Horymir23/iaapa2026-stand/assets/grafika/2 TV 55.jpg

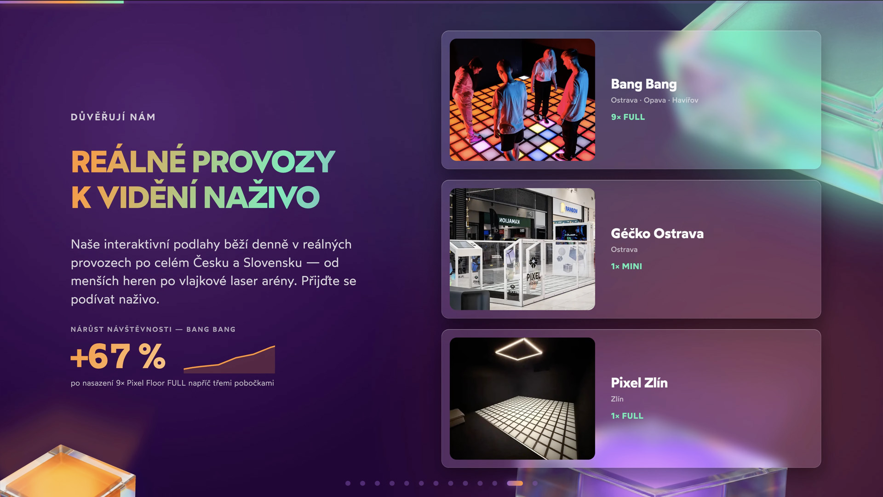
assets/grafika/2 TV 55.jpg
