Horymir23/iaapa2026-stand/assets/grafika/Poutač360v2.jpg

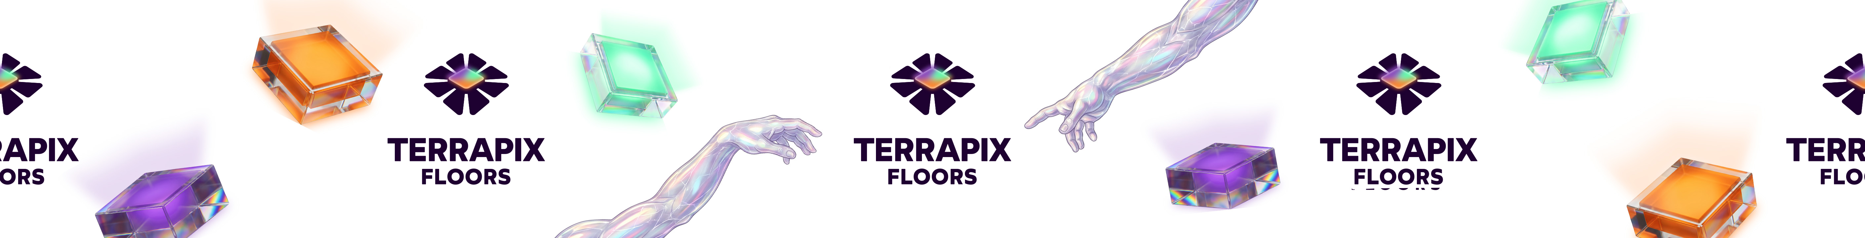
assets/grafika/Poutač360v2.jpg
