Horymir23/iaapa2026-stand/data/Shell Scheme.pdf

## IAAPA Expo Europe 2026

## BLANK SHELL BOOTH

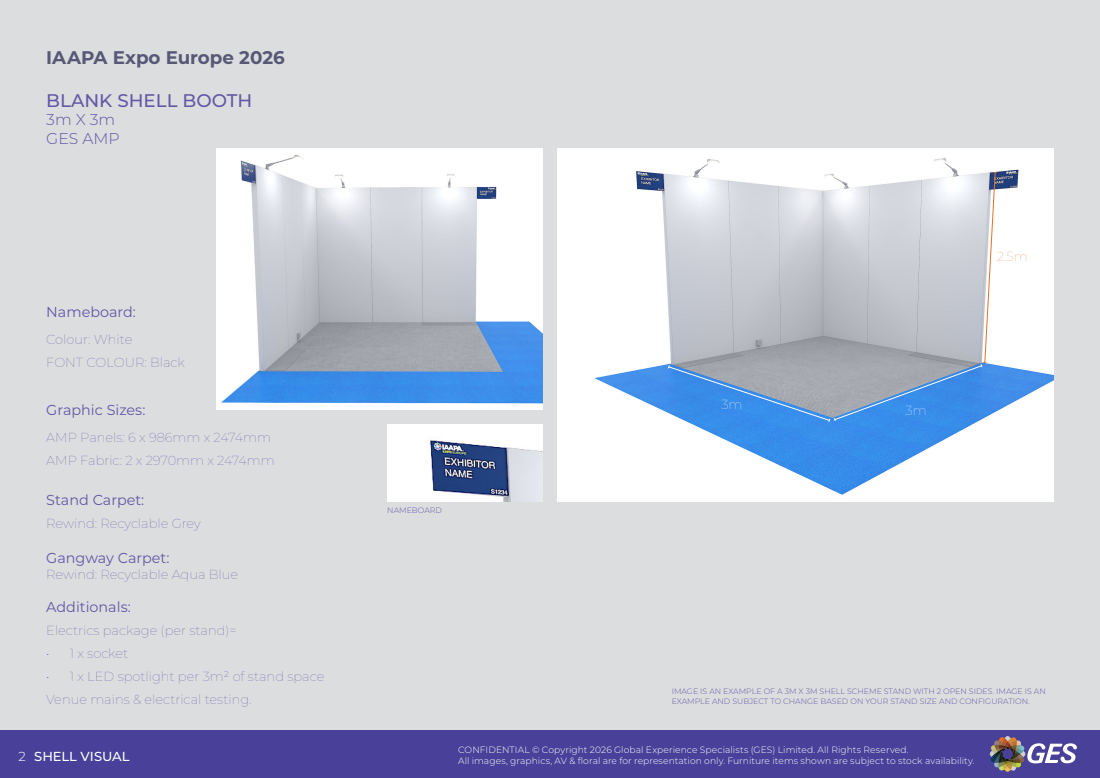
[picture p3: page 1]
NAMEBOARD; 2 SHELL VISUAL; 3m X 3m GES AMP; Graphic Sizes:; AMP Panels: 6 x 986mm x 2474mm AMP Fabric: 2 x 2970mm x 2474mm; Venue mains & electrical testing.; IMAGE IS AN EXAMPLE OF A 3M X 3M SHELL SCHEME STAND WITH 2 OPEN SIDES. IMAGE IS AN

Nameboard:
Colour: White
FONT COLOUR: Black

Stand Carpet:
Rewind: Recyclable Grey
Gangway Carpet:
Rewind: Recyclable Aqua Blue
Additionals:
Electrics package (per stand)=
• 1 x socket
• 1 x LED spotlight per 3m² of stand space

EXAMPLE AND SUBJECT TO CHANGE BASED ON YOUR STAND SIZE AND CONFIGURATION.

CONFIDENTIAL © Copyright 2026 Global Experience Specialists (GES) Limited. All Rights Reserved.
All images, graphics, AV & floral are for representation only. Furniture items shown are subject to stock availability.
