Horymir23/iaapa2026-stand/assets/Plans/RIGGING_PLAN_upraveny.pdf

## RIGGING PLAN

STAND: S4244
HI-TECH DIGITAL MODULES S.R.O. SCALE 1:50 (A3)

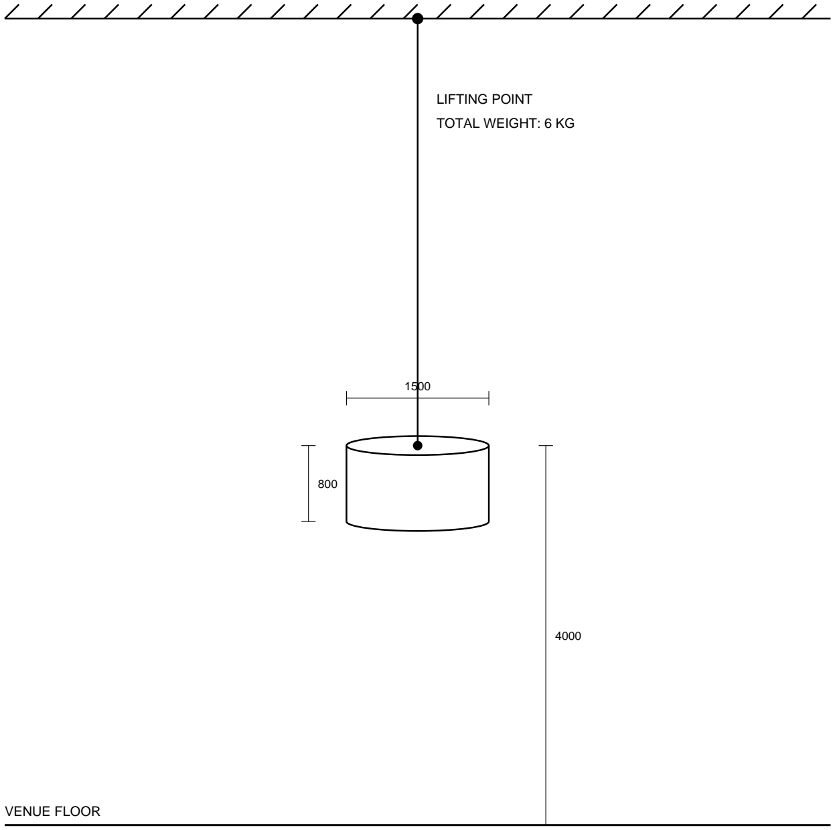
[picture p6: figure]
VENUE FLOOR; LIFTING POINT TOTAL WEIGHT: 6 KG

6000

3000

3000

2250 | 2250

1000

500

Ø 1500

VISITOR ENTRANCE

VISITOR ENTRANCE

STAND / DIVIDING WALL

STAND / DIVIDING WALL

LIFTING POINT | TOTAL WEIGHT: 6 KG

## RIGGING ELEVATION

STAND: S4244
SCALE 1:50 (A3)
