Horymir23/iaapa2026-stand/assets/audit/01-prehled.png

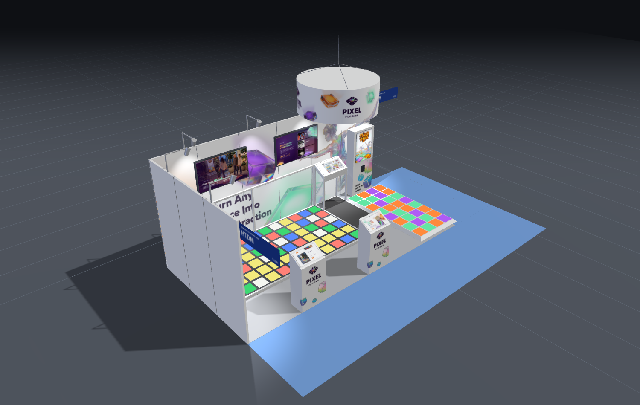
assets/audit/01-prehled.png
