Horymir23/iaapa2026-stand/assets/audit/02-pudorys.png

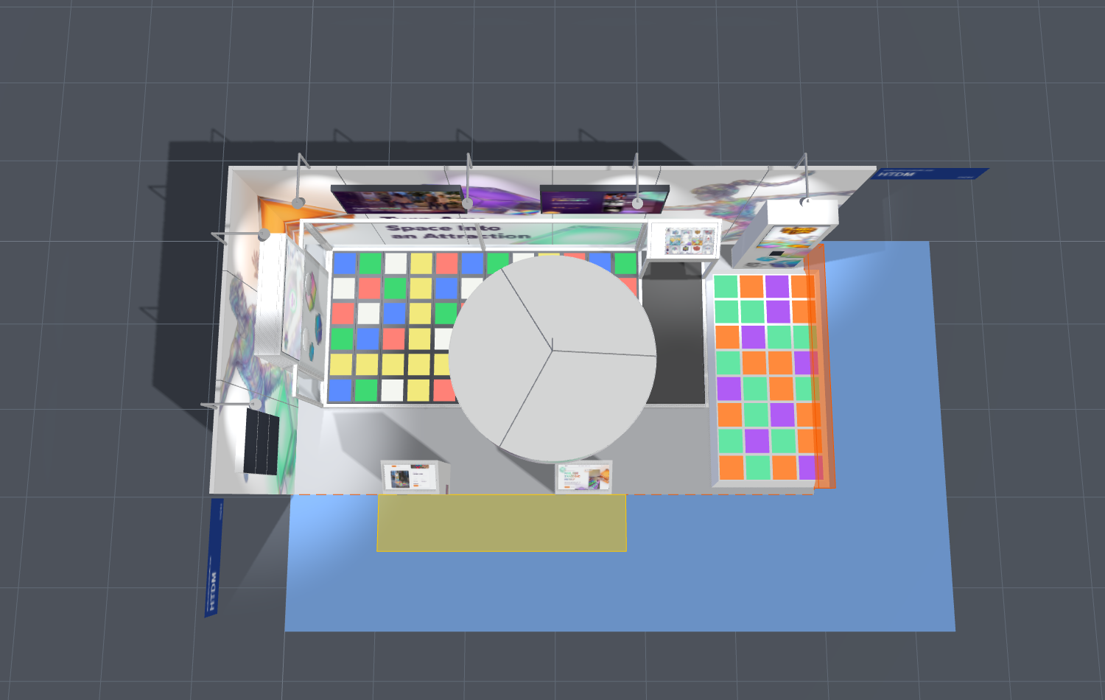
assets/audit/02-pudorys.png
