Horymir23/iaapa2026-stand/assets/audit/03-arcade-presah.png

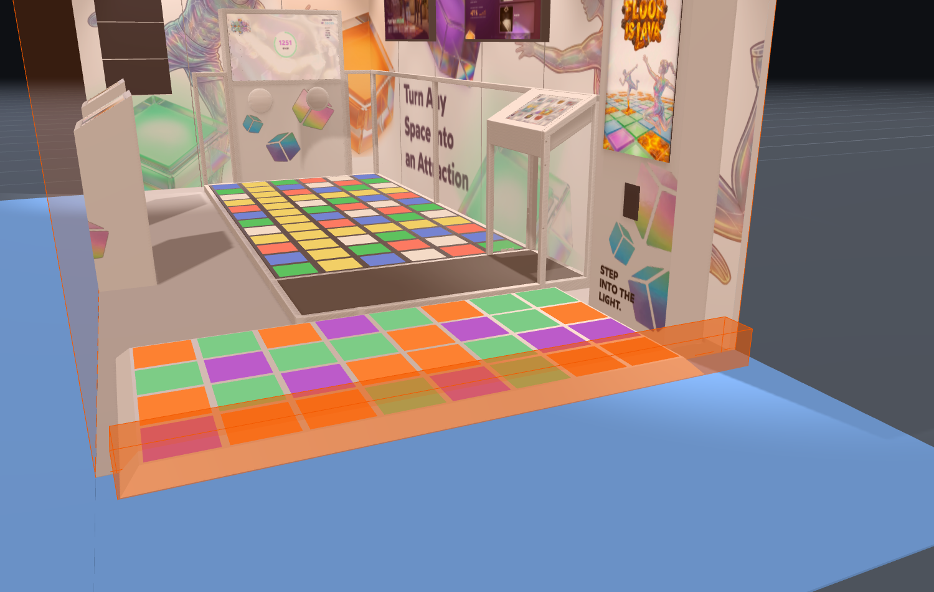
assets/audit/03-arcade-presah.png
