Horymir23/iaapa2026-stand/assets/audit/04-kiosky-ulicka.png

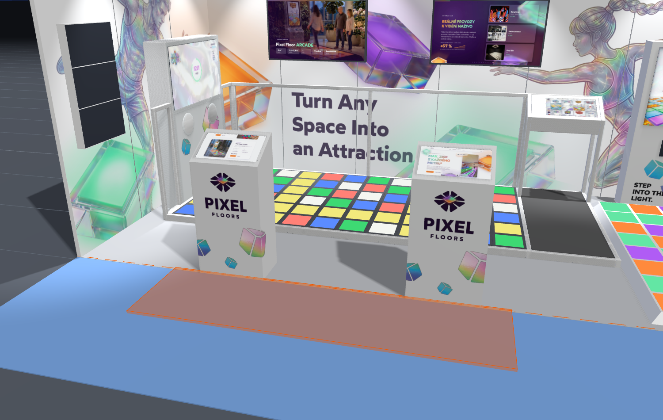
assets/audit/04-kiosky-ulicka.png
