Horymir23/iaapa2026-stand/assets/audit/05-kiosek-vyska.png

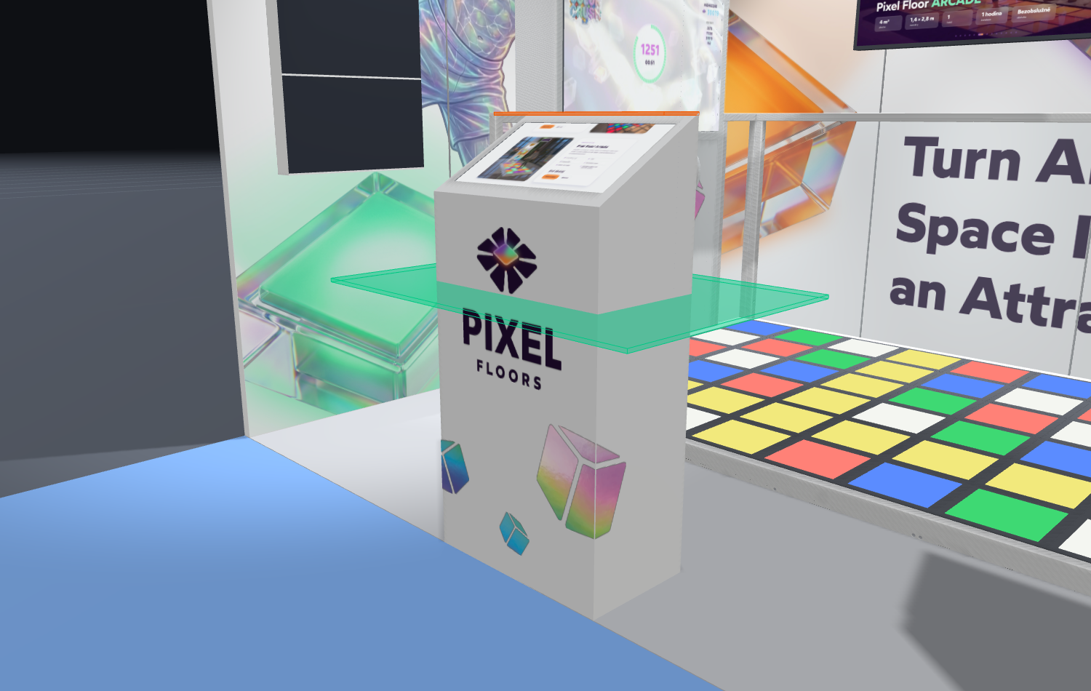
assets/audit/05-kiosek-vyska.png
