Horymir23/iaapa2026-stand/assets/audit/06-podlaha-schod.png

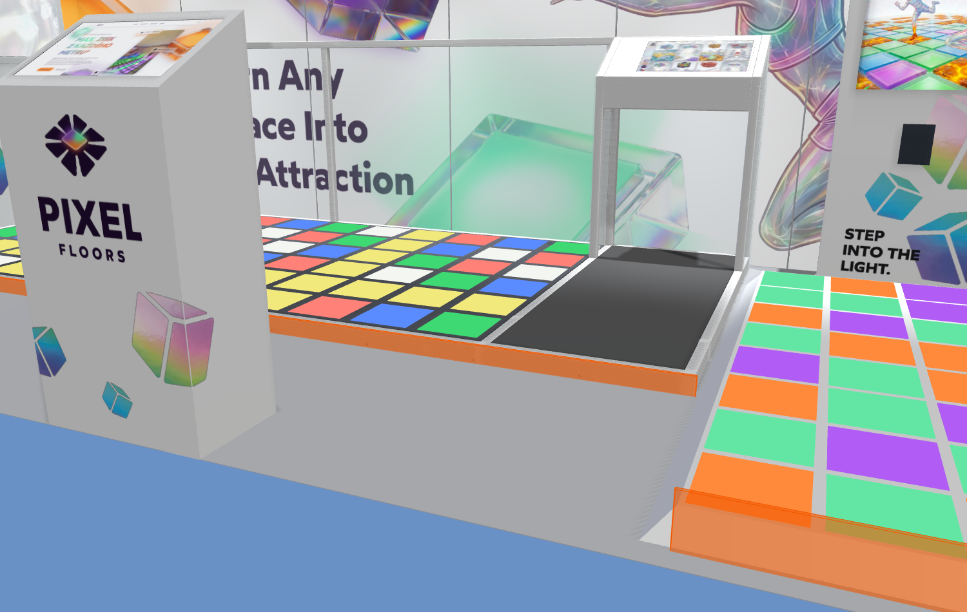
assets/audit/06-podlaha-schod.png
