Horymir23/iaapa2026-stand/assets/audit/07-poutac.png

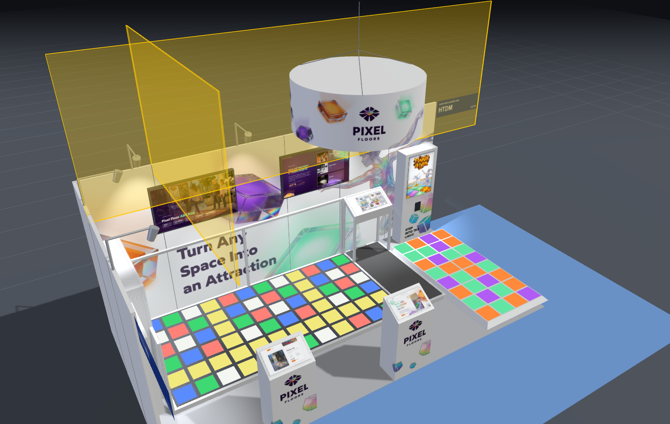
assets/audit/07-poutac.png
