Horymir23/iaapa2026-stand/assets/export/tisk/arcade-telo.jpg

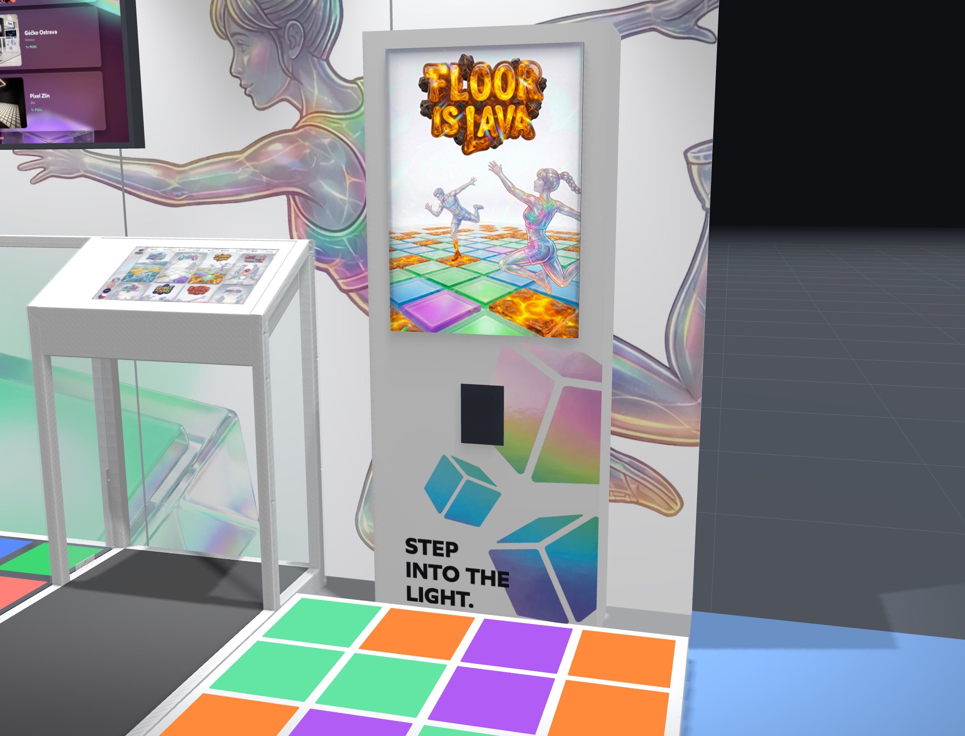
assets/export/tisk/arcade-telo.jpg
