Horymir23/iaapa2026-stand/assets/export/tisk/kiosek-celo.jpg

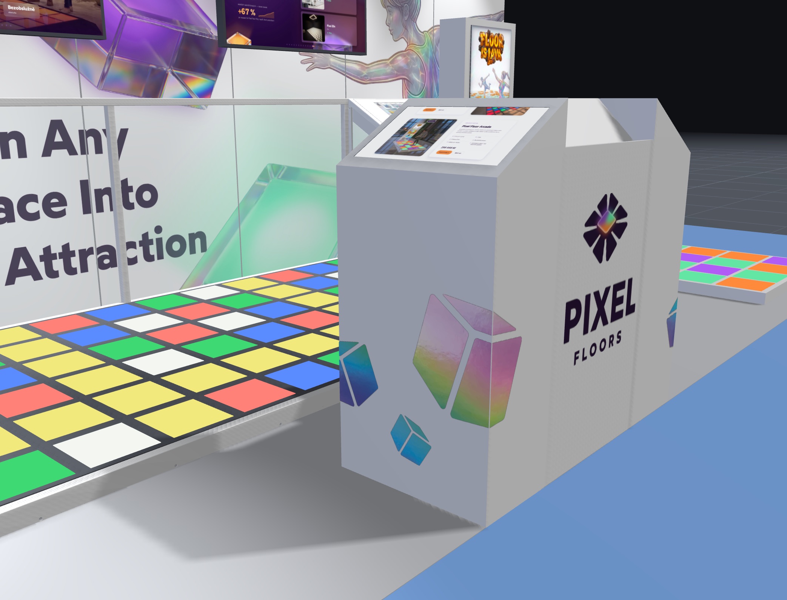
assets/export/tisk/kiosek-celo.jpg
