Horymir23/iaapa2026-stand/assets/export/tisk/kiosky-sestava.jpg

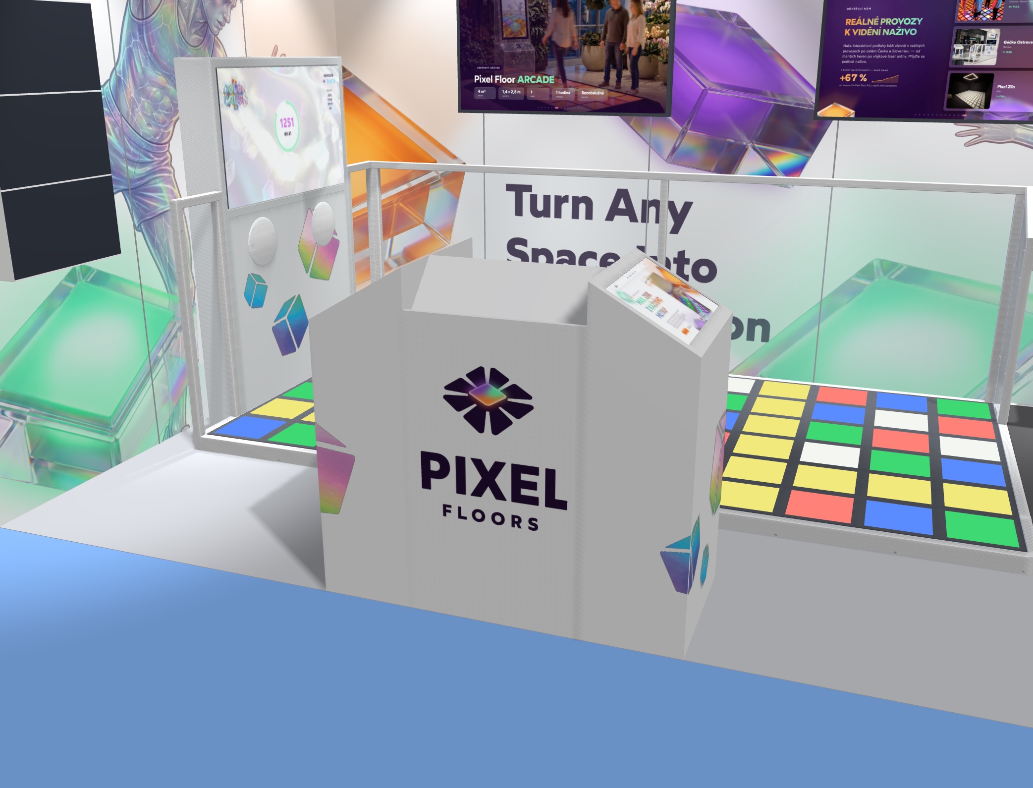
assets/export/tisk/kiosky-sestava.jpg
