Horymir23/iaapa2026-stand/assets/export/tisk/poutac.jpg

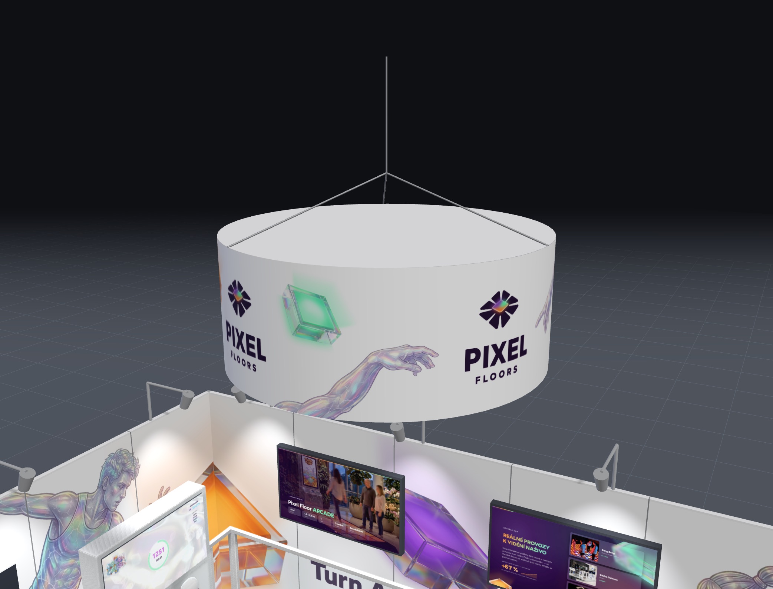
assets/export/tisk/poutac.jpg
