Horymir23/iaapa2026-stand/assets/export/tisk/prehled.jpg

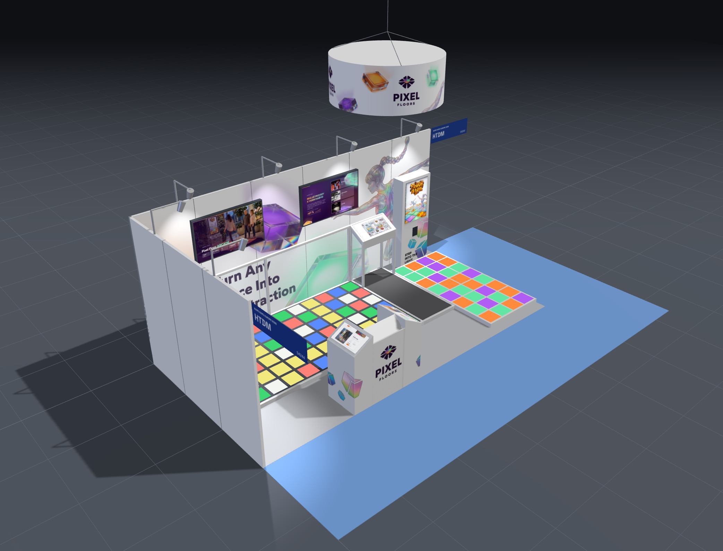
assets/export/tisk/prehled.jpg
