Horymir23/iaapa2026-stand/assets/export/tisk/stena-a.jpg

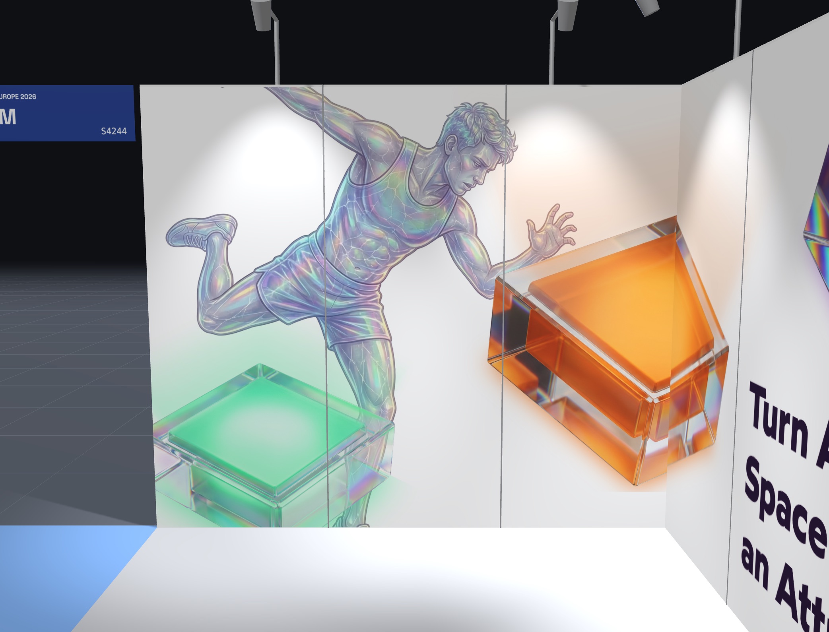
assets/export/tisk/stena-a.jpg
