Horymir23/iaapa2026-stand/assets/export/tisk/stena-b.jpg

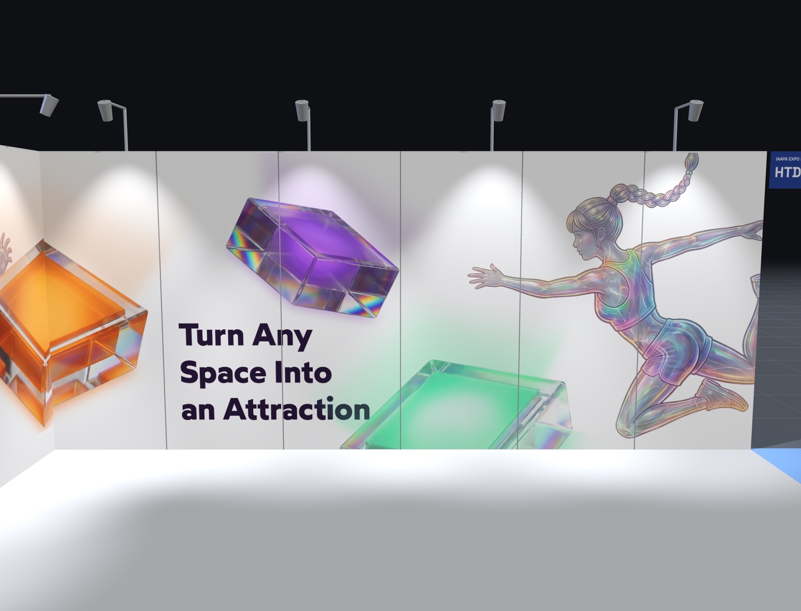
assets/export/tisk/stena-b.jpg
