Horymir23/iaapa2026-stand/assets/export/tisk/vez-mini.jpg

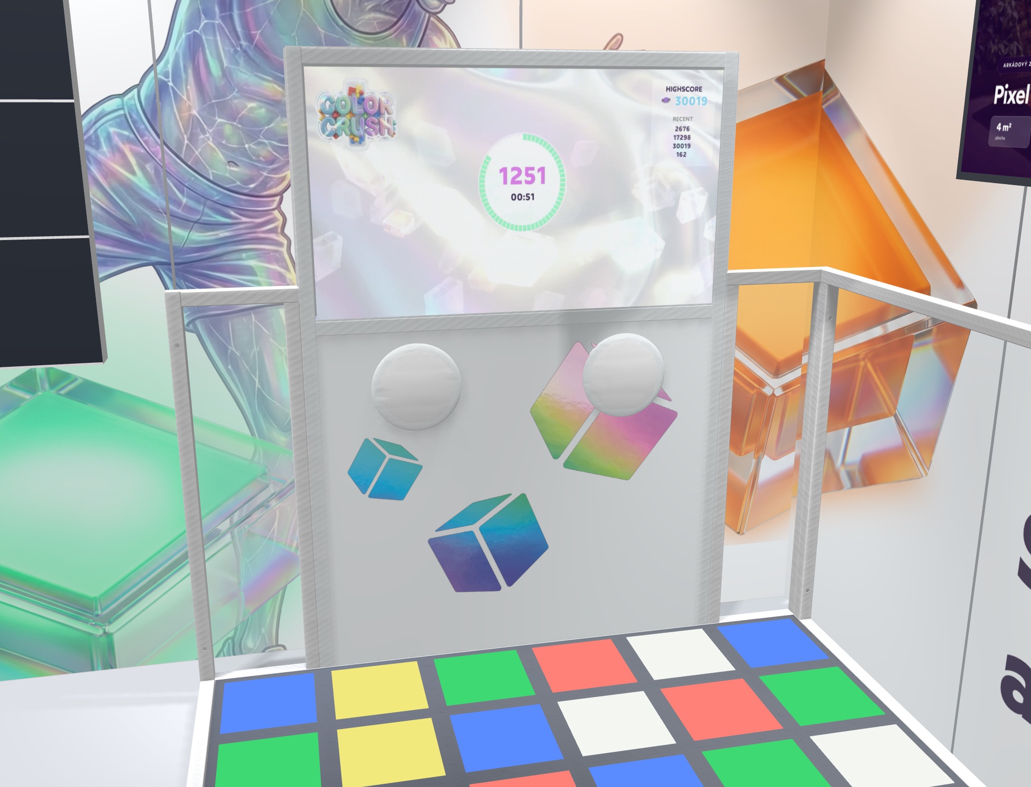
assets/export/tisk/vez-mini.jpg
