Horymir23/iaapa2026-stand/assets/grafika/1 TV 55.jpg

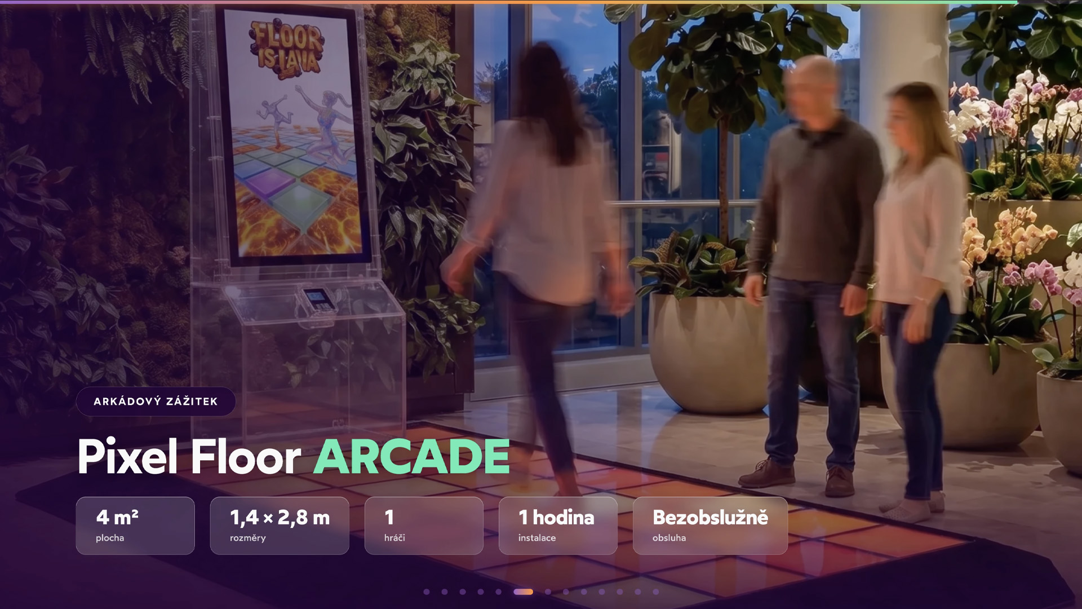
assets/grafika/1 TV 55.jpg
