Horymir23/iaapa2026-stand/assets/grafika/6 mini monitor na vezi.jpg

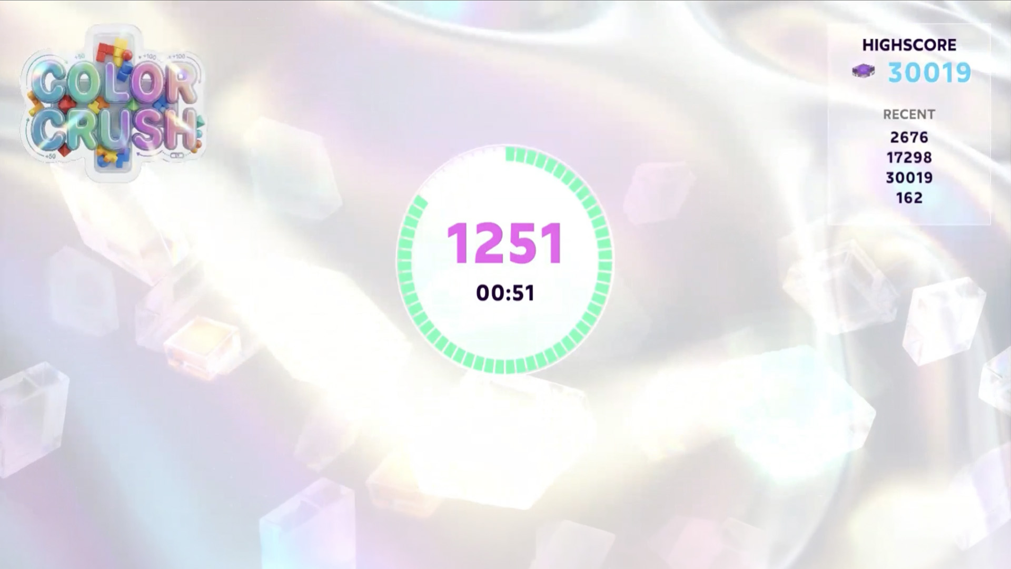
assets/grafika/6 mini monitor na vezi.jpg
