Horymir23/iaapa2026-stand/assets/grafika/7 mini monitor na pultu.jpg

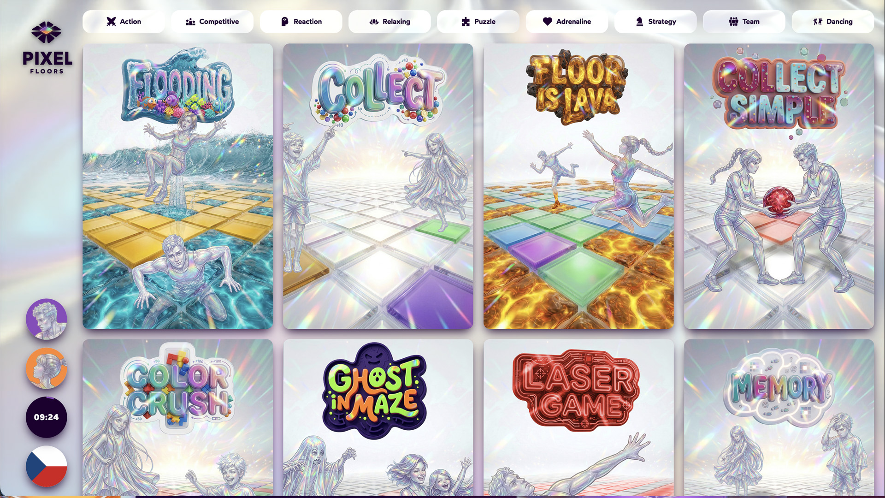
assets/grafika/7 mini monitor na pultu.jpg
