Horymir23/iaapa2026-stand/assets/grafika/8 arcade totem.jpg

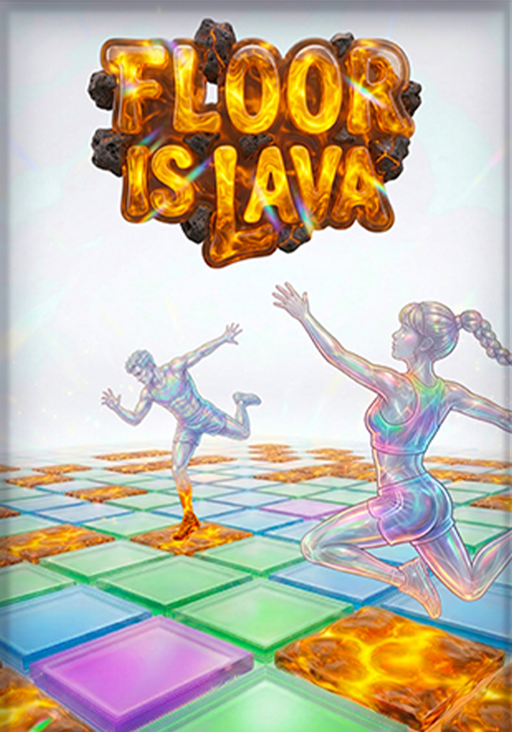
assets/grafika/8 arcade totem.jpg
