Horymir23/iaapa2026-stand/assets/grafika/9 Kiosek 1.jpg

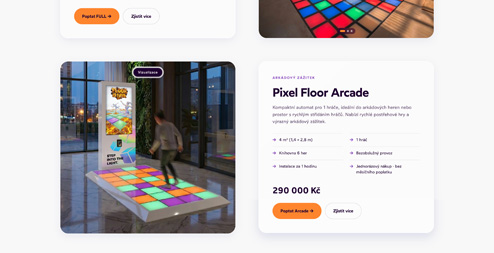
assets/grafika/9 Kiosek 1.jpg
