Horymir23/iaapa2026-stand/assets/grafika/10 Kiosek 2.jpg

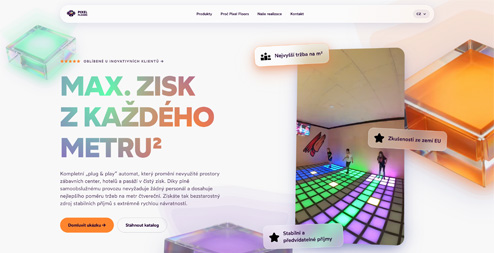
assets/grafika/10 Kiosek 2.jpg
