Horymir23/iaapa2026-stand/assets/grafika/Arcade.webp

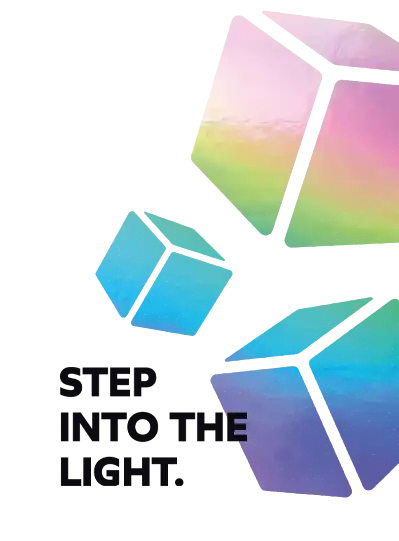
assets/grafika/Arcade.webp
