Horymir23/iaapa2026-stand/assets/grafika/Stěna A v1.jpg

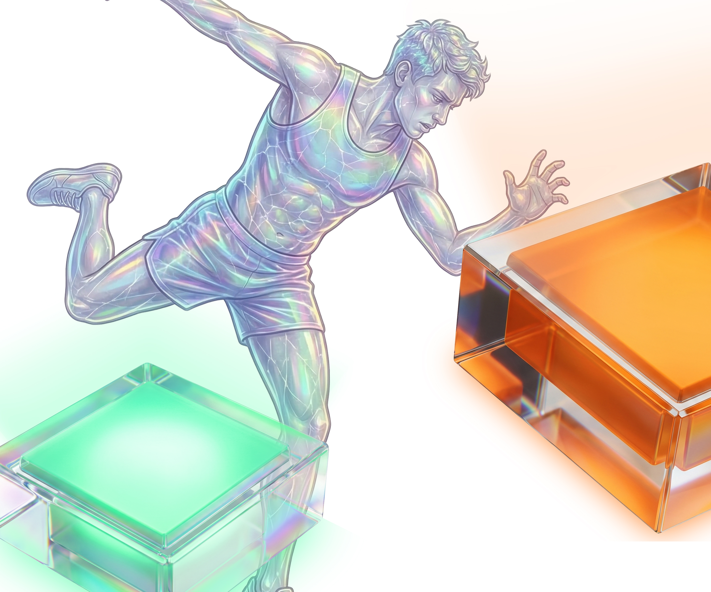
assets/grafika/Stěna A v1.jpg
