Horymir23/iaapa2026-stand/assets/grafika/Stěna B v3.jpg

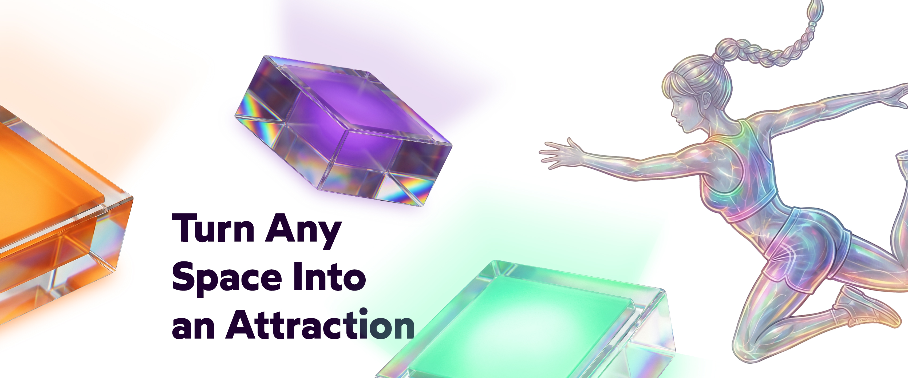
assets/grafika/Stěna B v3.jpg
