Horymir23/iaapa2026-stand/data/preview.webp

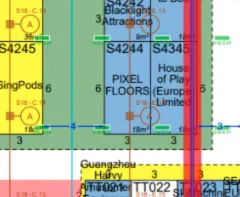
data/preview.webp
