Horymir23/iaapa2026-stand/model/banner_v_stanku.stl

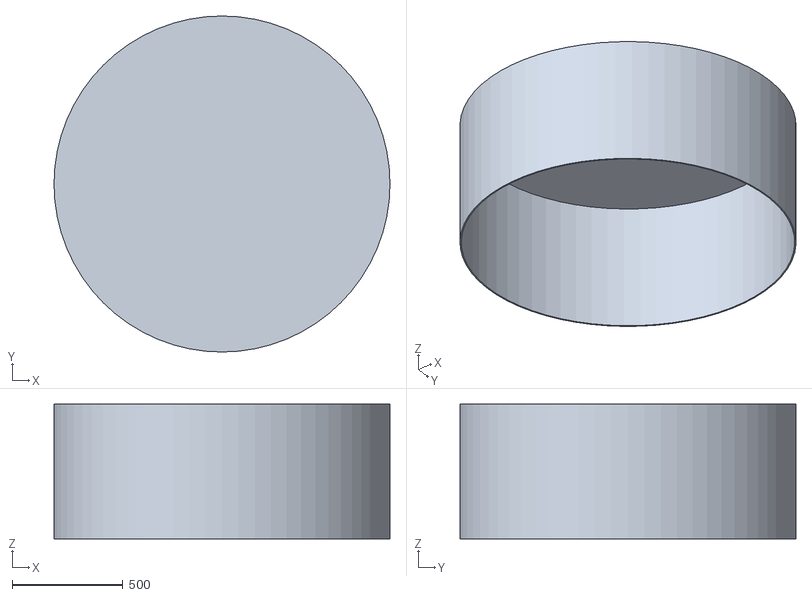
[picture p32: CAD file, 2026-08-18]
model/banner_v_stanku.stl
1520.0 x 1520.0 x 610.0
