Horymir23/iaapa2026-stand/model/stanek_S4244.stl

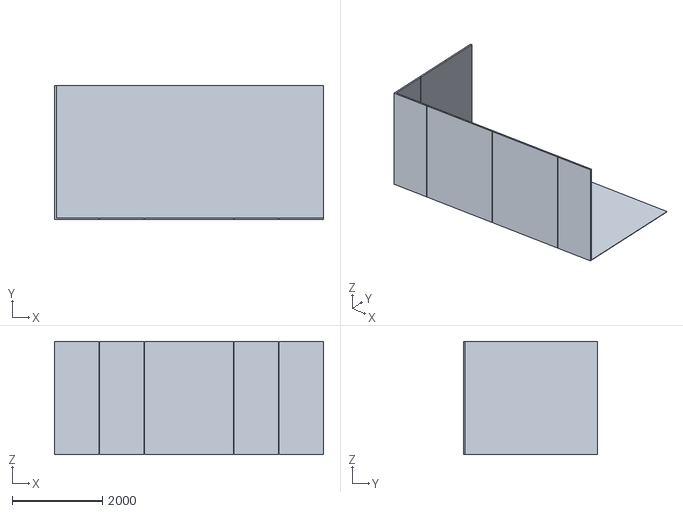
[picture p33: CAD file, 2026-08-18]
model/stanek_S4244.stl
5951.0 x 2970.0 x 2510.0
