Horymir23/iaapa2026-stand/model/kiosk_v_stanku.stl

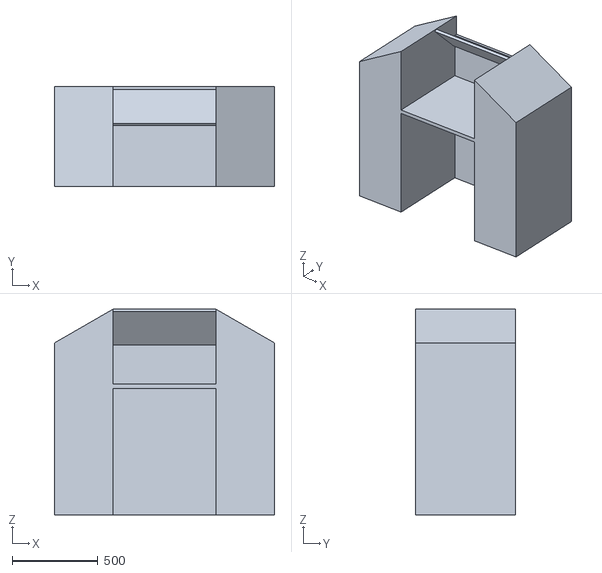
[picture p34: CAD file, 2026-07-21]
model/kiosk_v_stanku.stl
1280.0 x 580.0 x 1196.0
