Horymir23/iaapa2026-stand/model/arcade_v_stanku.stl

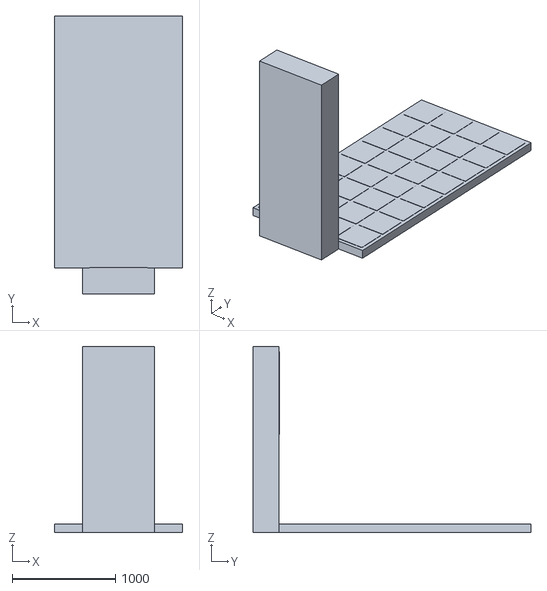
[picture p35: CAD file, 2026-07-21]
model/arcade_v_stanku.stl
1240.0 x 2690.0 x 1800.0
