Horymir23/iaapa2026-stand/model/mini_v_stanku.stl

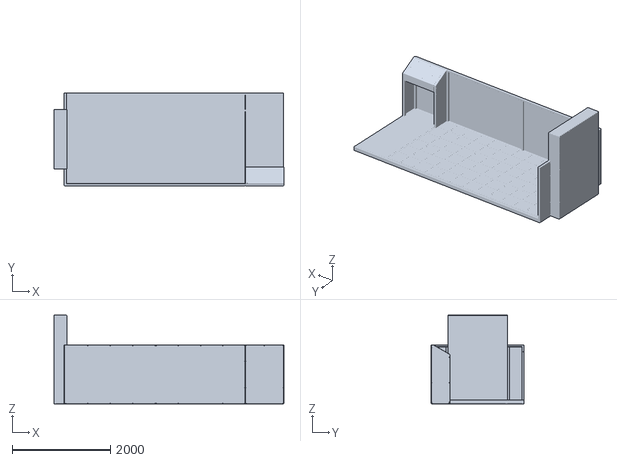
[picture p36: CAD file, 2026-07-17]
model/mini_v_stanku.stl
4677.0 x 1893.0 x 1803.0
