Horymir23/iaapa2026-stand/assets/Plans/RIGGING_PLAN_S4244_korekce.pdf

## RIGGING PLAN

## RIGGING ELEVATION

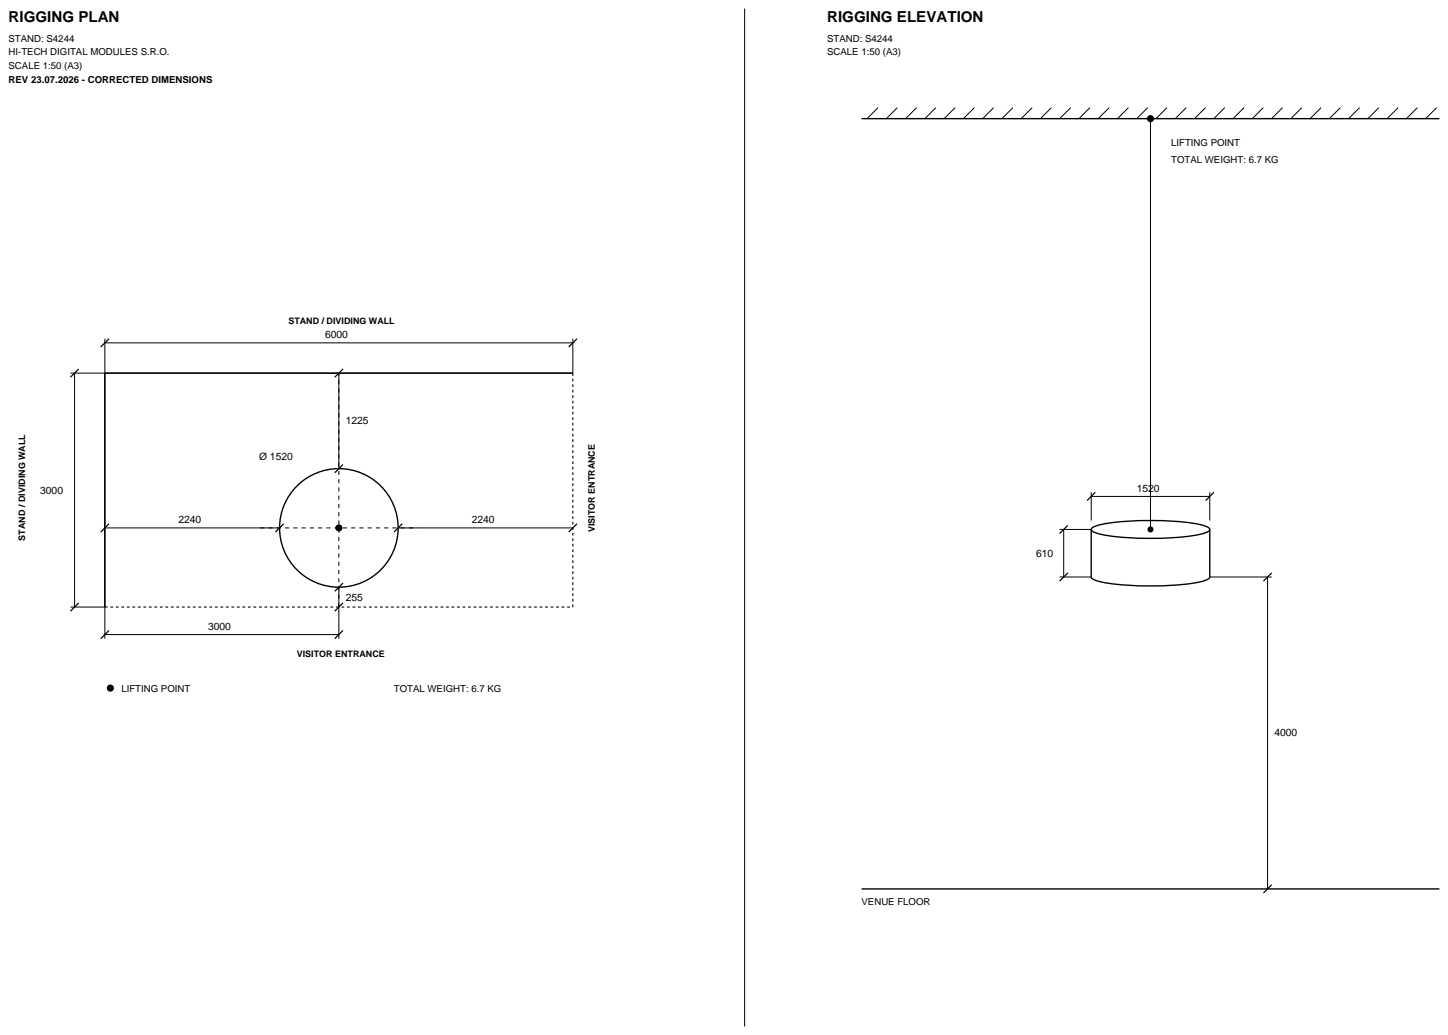
[picture p38: page 1]
VISITOR ENTRANCE; LIFTING POINT; TOTAL WEIGHT: 6.7 KG; STAND: S4244 SCALE 1:50 (A3); VENUE FLOOR

STAND: S4244
HI-TECH DIGITAL MODULES S.R.O.
SCALE 1:50 (A3)
REV 23.07.2026 - CORRECTED DIMENSIONS

LIFTING POINT
TOTAL WEIGHT: 6.7 KG

STAND / DIVIDING WALL
