Horymir23/iaapa2026-stand/(commit log)

2026-07-15 Initial commit — stánek S4244, web viewer + modely + spec
    [arcade_v_stanku.stl, banner_v_stanku.stl, kiosk_v_stanku.stl, mini.stp, mini_v_stanku.stl, stanek_S4244.stl]
2026-07-16 Graphics for monitors
    Číslování a nahrávání grafiky pro všech 10 obrazovek stánku:
    přepínač čísel + rozevírací seznam nahrávacích polí s rozměry.
    Doladění proti předchozímu commitu:
    - monitor na věži mini je 1123×643 mm (změřeno z líce displeje
    v mini-mesh.js, ne z rohových vrcholů) — dřív 903×483
    - překryvy šikmých obrazovek (pult mini, kiosky) posazeny na
    změřený líc skla, dřív byly utopené ve skříni
    Odstraněny dočasné testovací kopie vieweru (_check_monitors*.html),
    které se do repa dostaly omylem.
2026-07-16 Mini hole fix
    [mini_v_stanku.stl]
2026-07-17 Monitors buf fix
    [kiosk_v_stanku.stl, mini_v_stanku.stl]
2026-07-21 Mini and Arcade fix
    [arcade_v_stanku.stl, kiosk_v_stanku.stl]
2026-07-21 Kiosky natočení
    [kiosk_v_stanku.stl]
2026-07-21 Krycí deska
    [kiosk_v_stanku.stl]
2026-07-23 Rigging plan
    [banner_v_stanku.stl]
2026-08-15 Tisková data — návod pro tisk grafiky (web/tisk.html)
    Nová stránka: každý tištěný prvek se screenshotem z 3D modelu, finálním
    rozměrem, odvozením (potvrzeno/odhad/návrh), potřebným DPI a dotazy pro
    výrobce (GES + dodavatel poutače) v EN ke zkopírování. Hodnoty se čtou
    živě ze stand-spec.json, statický otisk slouží jako fallback pro file://.
    Screenshoty v assets/export/tisk/ (výjimka v .gitignore — součást webu).
2026-08-15 Odpověď GES 24.–25.7.2026: panely Foamex, vlastní vinyl povolen
    Do confirmed přidáno panel_material (Foamex, hladký) a own_graphics
    (samolepicí vinyl i velcro povoleny; bez poškození a reziduí; GES u
    vlastní grafiky neručí). Open question povrchu panelů uzavřena, nově
    úkol dohledat přílohu GES s přesnými rozměry panelů (může potvrdit
    rozpal stěny B). graphics_production.decided = fólie; koncept HTDM:
    bílé panely zůstávají, lepí se jen řezané/kiss-cut prvky.
    web/tisk.html: materiál stěn POTVRZENO, dotazy pro GES přečíslované
    (zbývají 4), zelený box se zodpovězeným.
2026-08-18 Příloha GES + rozhodnutí o fólii + stránka s dotazem pro tiskárnu
    PŘÍLOHA GES "AMP Dos and don'ts" (data/, necommitováno — viz .gitignore):
    obsah přepsán do spec → confirmed.amp_file_guide. Potvrzuje panel 986×2474,
    půlpanel 489×2474, SPÁRU 7 mm, tištěné desky z rigidního materiálu 3 mm na
    suchý zip (velcro po obvodu, min. 24 h před show), zákaz hřebíků/vrutů/sponek/
    malování a textil jedním kusem až do 10 m (visual 2976/5952 → svislý spoj na
    stěně B odpadá, dřívější předpoklad 2 kusů byl chybný).
    V našem exempláři PDF je ručně přeškrtnuté "provided by GES" u oboustranných
    podložek (anotace /Ink z 24.7. 08:28) → GES vlastní lepen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
    [banner_v_stanku.stl, stanek_S4244.stl]
2026-08-18 InDesign: skript pro založení návrhových dokumentů stěn
    assets/indesign/priprava-dokumentu.jsx — vytvoří dokument pro každou stěnu
    (6 a 3 panely) s vodítky na hranách panelů i spár, obrysy panelů s popisky,
    výškovými vodítky (pult 760, zábradlí 1200, TV 1495/2205, věž 1803) a vrstvami
    Panely / Zákryty / Grafika / Kóty + spot barvou CutContour pro řezový plotr.
    Dvě věci, na které skript upozorňuje v komentářích:
    - InDesign nedovolí stránku nad 5486 mm, delší stěna má 5951 → návrh běží
    ve zmenšeném měřítku (konstanta SCALE, výchozí 1:5); finální data pro řez
    se kreslí zvlášť 1:1.
    - Kde grafická plocha 2474 začíná nad podlah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
2026-08-18 Spáry se zahrnují: prvky přes spáru se dělí, ne obcházejí
    ZADÁNÍ UŽIVATELE 18.8.2026: grafika je hotová, prvky se nebudou přesouvat
    mimo spáry. Zapsáno do spec → graphics_production.seam_handling.
    Technika (doplněno do web/tisk.html, sekce 03): z prvku přes spáru musí
    ZMIZET 7 mm, ne ho jen rozříznout — jinak se díly na dvou panelech odsadí
    o 7 mm a prvek je o 7 mm širší, než je navržený. Odebíraných 7 mm ale NENÍ
    3,5 + 3,5 z každé půlky: dělení je nesymetrické podle toho, kde spára prvek
    trefí (levý díl končí na hraně svého panelu, pravý začíná na hraně dalšího).
    V InDesignu obdélníkem 7 mm přes Průzkumník cest → Odečíst.
    D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
2026-08-18 InDesign skript: výchozí měřítko 1:5 → 1:2
    Návrh uživatele: při požadavku 150 dpi ve finální velikosti lze pracovat
    v 1:2 při 300 dpi. Ověřeno — je to identický rastr (35 144 × 14 610 px pro
    delší stěnu), měřítko a rozlišení se vykrátí. 1:2 je praktičtější než 1:5:
    300 dpi je standardní hodnota a přepočty se dělají dvěma. Stránka vyjde
    2975,5 × 1237 mm, tedy pod limitem InDesignu 5486 mm.
    Do hlavičky skriptu doplněno, že vložené bitmapy musí mít v panelu Vazby
    EFEKTIVNÍ 300 ppi (ne nativní).
2026-08-18 InDesign skript přepsán: dokument pro tisková data, 1 stránka = 1 panel
    Upřesnění zadání: skript má zakládat dokument pro PŘÍPRAVU TISKOVÝCH DAT,
    ne návrhový dokument kompozice. Přepsáno.
    Nově: 1 stránka = 1 panel 986 × 2474 mm v měřítku 1:1 (6 stránek stěna B,
    3 stěna A, dva dokumenty). Panel je hluboko pod limitem InDesignu 5486 mm,
    takže MĚŘÍTKO NENÍ POTŘEBA VŮBEC — bitmapy stačí na 150 dpi v této velikosti
    (5823 × 14610 px na panel). Měřítko 1:2 mělo smysl jen pro návrh celé stěny.
    Dělení prvků přes spáru se tím řeší samo: stránka končí na hraně panelu,
    přesah se ořízne a na další stránce začne zbytek posunutý o rozte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
2026-09-11 Tisková data po panelech, skripty Adobe do assets/skripty, dotaz na tiskárnu
    - spec: print_files (9× TIF 996 × 2484 mm, spád 5 mm na stranu) a varianta
    prořezání spáry na zdi (alternative_cut_on_wall, nerozhodnuto)
    - assets/indesign → assets/skripty (Photoshop rozřez na panely, ořezové cesty,
    Illustrator CutContour); produkční TIF/PSB v assets/grafika/Tiskové/ ignorovány
    - web/tiskarna.html: dotaz č. 4 na prořezání spáry
2026-09-11 Logo na stole → Vertical tagline.svg (TERRAPIX FLOORS), nový Poutač360v2
    - TABLE_LOGO ve vieweru, spec product_kiosk.table.graphics, tisk.html (poměr
    stran 319,18 × 309,93 → výška ≈ 486 mm, hrany 397–883 mm) a skill stand-3d
    - Poutač360v2.jpg předělaný uživatelem; gfx-default.js přegenerován
